790266459/LLC/整机BOM标和变压器规格书/整机BOM标2019-08-28.xls

500W双管正激套件整体BOM
名称/型号 | 位号 | 封装 | 数量 | 参考价格单价 | 备注
683/630V/1210 | C16 | 1210 | 1 | 0.75 | KEMET(基美)-C1210V683KBRAC7800 (https://list.szlcsc.com/brand/435.html)
475/50V/1206 | C5, C10, C22 | 1206 | 3 | 0.384 | 风华
106/25V/1206 | C19, C49 | 1206 | 2 | 0.285 | 风华
224/250V/1206 | C24，C45 | 1206 | 2 | 0.378 | HEC(禾伸堂)-C1206X224K251T (https://list.szlcsc.com/brand/1173.html)
223/500V/1206 | C47 | 1206 | 1 | 0.302 | YAGEO(国巨)-CC1206KKX7RBBB223 (https://list.szlcsc.com/brand/396.html)
102/1KV/1206 | C15, C17, C23, C25, C42 | 1206 | 5 | 0.116 | 风华
222/1KV/1206 | C12 | 1206 | 1 | 0.124 | 风华
103/1KV/1206 | C54 | 1206 | 1 | 0.1 | 风华
471/1KV/1206/COG | C4, C7 | 1206 | 2 | 0.274 | YAGEO(国巨)-CC1206JKNPOCBN471 (https://list.szlcsc.com/brand/396.html)
331/50V/0603 | C37 | 0603 | 1 | 0.0177 | 风华
102/50V/0603 | C40, C41 | 0603 | 2 | 0.0155 | 风华
472/50V/0603 | C34 | 0603 | 1 | 0.0186 | 风华
103/50V/0603 | C38, C43 | 0603 | 2 | 0.034 | 风华
104/50V/0603 | C14, C32, C36, C44, C46, C55 | 0603 | 6 | 0.0133 | 风华
105/50V/0603 | C30, C39, C48, C59，C33, C35 | 0603 | 6 | 0.127 | 风华
0.005R 1%/2512 | R9, R13 | 2512封装 | 2 | 0.42 | 台湾大毅-RLP25FEER005 (https://list.szlcsc.com/brand/1238.html)
22R/2512 | R1, R10 | 2512封装 | 2 | 0.1 | 厚生
1K/2512 | R12, R14 | 2512封装 | 2 | 0.137 | 厚生
1R/1206 | R53 | 1206 | 1 | 0.023 | 厚生
1.2R/1206 | R47 | 1206 | 1 | 0.02 | 厚生
2R 1%/1206 | R42 | 1206 | 1 | 0.019 | 厚生
3R 1%/1206 | R41 | 1206 | 1 | 0.2 | 厚生
3.3R/1206 | R2, R17 | 1206 | 2 | 0.2 | 厚生
12R/1206 | R11, R49 | 1206 | 2 | 0.2 | 厚生
20R 1%/1206 | R24, R25 | 1206 | 2 | 0.017 | 厚生
22R/1206 | R32, R45 | 1206 | 2 | 0.2 | 厚生
39R/1206 | R46 | 1206 | 1 | 0.2 | 厚生
220R/1206 | R99 | 1206 | 1 | 0.2 | 厚生
910R 1%/1206 | R37 | 1206 | 1 | 0.2 | 厚生
2K 1%/1206 | R34, R48, R57, R78，R80 | 1206 | 5 | 0.2 | 厚生
3.9K 1%/1206 | R43 | 1206 | 1 | 0.2 | 厚生
4.7K/1206 | R7, R19 | 1206 | 2 | 0.2 | 厚生
8.2K 1%/1206 | R85 | 1206 | 1 | 0.2 | 厚生
9.1K 1%/1206 | R79 | 1206 | 1 | 0.2 | 厚生
10K/1206 | R23 | 1206 | 1 | 0.2 | 厚生
75K/1206 | R3, R4, R6 | 1206 | 3 | 0.2 | 厚生
100K 1%/1206 | R76 | 1206 | 1 | 0.2 | 厚生
150K 1%/1206 | R77, R81 | 1206 | 2 | 0.2 | 厚生
220K/1206 | R28, R29 | 1206 | 2 | 0.2 | 厚生
470K 1%/1206 | R27 | 1206 | 1 | 0.2 | 厚生
200R/0603 | R94 | 0603 | 1 | 0.05 | 厚生
910R 1%/0603 | R62 | 0603 | 1 | 0.05 | 厚生
1K 1%/0603 | R16, R26, R82，R105 | 0603 | 4 | 0.05 | 厚生
2K 1%/0603 | R87, R89，R73, R91, R104 | 0603 | 5 | 0.05 | 厚生
2.2K 1%/0603 | R22 | 0603 | 1 | 0.05 | 厚生
3.9K 1%/0603 | R60 | 0603 | 1 | 0.05 | 厚生
10K 1%/0603 | R21,R51, R58, R83, R86, R88, R92, R97, R98,R67, R68, R74, R93 | 0603 | 13 | 0.05 | 厚生
39K 1%/0603 | R20, R84, R95, R96, R102 | 0603 | 5 | 0.05 | 厚生
100K/0603 | R100 | 0603 | 1 | 0.05 | 厚生
120K 1%/0603 | R15 | 0603 | 1 | 0.05 | 厚生
200K/0603 | R101, R103 | 0603 | 2 | 0.05 | 厚生
470K 1%/0603 | R72, R75 | 0603 | 2 | 0.05 | 厚生
910K 1%/0603 | R70 | 0603 | 1 | 0.05 | 厚生
M7 | D5, D6 | SMA | 2 | 0.046 | MDD
SS2200 | D11, D13 | SMA | 2 | 0.155 | MDD
ES5J/SMC | D2, D3, D4, D10 | SMC | 4 | 0.317 | MDD
CJ7812 | Q4 | T0-252 | 1 | 0.77 | CJ江苏长电(授权代理)
B772 | Q2, Q3, Q7 | SOT-89 | 3 | 0.288 | CJ江苏长电(授权代理)-hfe=160~320
D882 | Q6 | SOT-89 | 1 | 0.267 | CJ江苏长电(授权代理)-hfe=160~320
7.5V | ZD3, ZD4 | SOD-123 | 2 | 0.12 | CJ江苏长电(授权代理)-MMSZ4693 (https://list.szlcsc.com/brand/64.html)
13V | ZD1, ZD2 | SOD-123 | 2 | 0.14 | CJ江苏长电(授权代理)-MMSZ5243B (https://list.szlcsc.com/brand/64.html)
E1J | D7, D8, D12, D14, D15, D17, D18, D19, D20, D23, D25, D26 | SOD-123 | 12 | 0.051 | 杨杰
1N5819HW | D16 | SOD-123 | 1 | 0.18 | CJ江苏长电(授权代理)
1N4148W-G | D21, D22, D24 | SOD-123 | 3 | 0.085 | CJ江苏长电(授权代理)
2N7002K | Q10, Q12, Q13, Q15 | SOT-23 | 4 | 0.1 | CJ江苏长电(授权代理)
BLM3401 | Q11 | SOT-23 | 1 | 0.278 | CJ江苏长电(授权代理)
CJ3404 | Q8, Q16 | SOT-23 | 2 | 0.204 | CJ江苏长电(授权代理)
ME431AXG | Q9, Q14 | SOT-23 | 2 | 0.151 | 南京微盟
EL817S1(A)(TU)-F | U10, U12 | SOP4 | 2 | 0.2 | 亿光
LM258DT | U7, U11 | SOP8 | 2 | 0.4 | ST
NCP1252A | U9 | SOP8 | 1 | 2.02 | ON
PN8370NEC-T1H | U3 | 直插-DIP8 | 1 | 1.14 | 芯鹏微
102/400V | Y1, Y2, Y3, Y4, Y5, Y6, Y7, Y8 | 直插脚距10MM | 8 | 0.087 | HEL鸿志-Y15F1D102ML (https://list.szlcsc.com/brand/1219.html)
MP2474KGD3XLC | X1, X2 | 直插脚距15 | 2 | 0.343 | SRD(圣融达)
MPP105J5190916LC | C1 | 直插脚距15 | 1 | 0.254 | SRD(圣融达)
ERJ1EM470D11OT/5*11 | C20,C50,C56, C57 | 直插5*11 | 4 | 0.112 | 艾华
RM270M035E150/6.3*15 | C2, C8, C9 | 直插6.3*15 | 3 | 1.25 | PolyCap-原厂汪泽涛13798405421
ERJ1VM221F12OT/8*12 | C18, C26 | 直插8*12 | 2 | 0.326 | 艾华
ERE1VM102W20OT/12.5/20 | C3, C11, C21 | 直插12.5*20 | 3 | 0.86 | 艾华
EGD2WM100G16OT/10*16 | C13 | 直插10*16 | 1 | 0.52 | 艾华
EKM127M2GL30RRS1P/18*30 | C6, C51, C52, C53 | 直插18*30 | 4 | 3.82 | 万裕-叶海光-13850537224
KNH8150A | Q1, Q5 | 直插-TO-247 | 2 | 4.22 | KIA
MBR40200 | D1, D9 | 直插-TO-247 | 2 | 2.82 | 海矽美-朱小姐-QQ：610546668
14D-561K | R5 | 直插 | 1 | 0.407 | HEL鸿志-14D561K (https://list.szlcsc.com/brand/1219.html)
GBJ5010 | BD1 | 直插 | 1 | 2.86 | MDD
12A 250V/5*20陶瓷/包热缩套管 | F1 | 直插 | 1 | 1.14 | Littelfuse(美国力特)-0324012.MXP (https://list.szlcsc.com/brand/110.html)
300V 1A | F2 | 直插 | 1 | 0.194 | TLC(竞沃)-SQT1.00M (https://list.szlcsc.com/brand/11675.html)
SMIH-S-112LM | K1 | 直插 | 1 | 2.7 | 淘宝-恒金电源（店铺）
SQ1918030153808L | LF1 | 直插 | 1 | 1.6 | 扁平共模电感-辛旭生-13701530232
8.25*3P | P1 | 直插 | 1 | 0.582 | DIBO(地博电子)-DBT50-8.25-3P (https://list.szlcsc.com/brand/11964.html)
12V 0.2A/4020风扇 | P2 | 直插-风机端口-2.54*2 | 1 | 15 | SNOWFAN -YY4020H12S 4020
NTC10K 3435/2.54端子/20CM | P3 | 直插-NTC端口-2.54*2 | 1 | 1.2 | 淘宝-深圳市东鑫创电子
散热片-F2-5孔 | J6 | 直插-绝缘片 | 1 | 3.2 | 淘宝-悦享生活家
散热片-F2-4孔 | J7 | 直插-绝缘片 | 1 | 2.5 | 淘宝-悦享生活家
4020风机安装位置 | J8 | 直插 | 1 | 0
5D-9 | R18 | 直插 | 1 | 0.141 | HEL鸿志-5D-9 (https://list.szlcsc.com/brand/1219.html)
100R 10W/长脚定做 | R8 | 直插 | 1 | 0.45 | 淘宝-优翔电子
M4螺母端子+方螺丝+接线鼻 | V+1, V-1 | 直插-M4端子 | 2 | 0.83 | 淘宝-鑫硕电子五金厂
固定铜柱M3*6MM | J1, J2, J3, J4, J5, J9 | 直插-M3 | 6 | 0.05 | 淘宝-以瑟旗舰店
输出调电压接口2.54*4P | P4 | 直插-2.54 4PIN立式 | 1 | 0.06
90度单排弯针2.54*8 | P5, P10, P11, P12, P13, P14 | 直插-2.54*8 | 6 | 0.015 | BOOMELE(博穆精密) (https://list.szlcsc.com/brand/86.html)
90度单排弯针2.54*5 | P6, P7, P8, P9 | 直插-2.54*5 | 4 | 0.015 | 型号：排针2.54-单排13P反弯
15uh/PQ2625 | L2 | 直插-PQ26 | 1 | 6.5 | 变压器厂，邓工：13530050515
22uh输出续流电感 | L1 | 直插 | 1 | 7.5 | 变压器厂，邓工：13530050515
EE10 1：100电流互感器 | CT2 | 直插-EE10 | 1 | 1 | 变压器厂，邓工：13530050515
EE13驱动变压器 | T3 | 直插-EE13/5+5 | 1 | 1.5 | 变压器厂，邓工：13530050515
EE16辅助电源变压器 | T2 | 直插-EE16 | 1 | 1.8 | 变压器厂，邓工：13530050515
ER4220主功率变压器 | T1 | 直插-ER4220 | 1 | 25 | 变压器厂，邓工：13530050515
其他辅料
六角铜柱M3单头铜螺柱M3*15 | J1, J3, J4, J5, J9 |  | 5 | 1.2 | 淘宝-以瑟旗舰店
固定散热片M3平头螺丝M3*6MM |  |  | 4 | 0.05 | 淘宝-以瑟旗舰店
MOS二极管锁散热片组合螺丝M3*12 |  |  | 6 | 0.11 | 淘宝-以瑟旗舰店
MOS和二极管绝缘片 |  |  | 4 | 0.22 | 兴勤导热-陈梦凝-18025851642
导热硅脂45g装-针管 |  |  | 1 | 5 | 兴勤导热-陈梦凝-18025851642
风扇和NTC位置2.54接插件*2套 |  |  | 1 | 0.12
风扇固定扎带3*200 |  |  | 2 | 0.026 | 淘宝-以瑟旗舰店
