790266459/LLC/主控制板原文件/控制主板.xls

Comment | Description | Designator | Footprint | LibRef | Quantity
104/50V/0603 | Capacitor | C14, C36, C44, C46 | 0603 | CAP | 4
475/50V/1206 | Capacitor | C22 | 1206 | CAP | 1
105/50V/0603 | Capacitor | C33, C35 | 0603 | CAP | 2
472/50V/0603 | Capacitor | C34 | 0603 | CAP | 1
331/50V/0603 | Capacitor | C37 | 0603 | CAP | 1
103/50V/0603 | Capacitor | C38, C43 | 0603 | CAP | 2
105/25V/0603 | Capacitor | C39, C48 | 0603 | CAP | 2
102/50V/0603 | Capacitor | C40, C41 | 0603 | CAP | 2
102/1KV/1206 | Capacitor | C42 | 1206 | CAP | 1
224 250V/1206 | Capacitor | C45 | 1206 | CAP | 1
223/500V/1206 | Capacitor | C47 | 1206 | CAP | 1
1N4148W-G | Diode | D21, D22 | SOD-123 | DIODE | 2
E1J | Diode | D23, D26 | SOD-123 | DIODE | 2
2.54*8 | Header, 8-Pin | P11, P13 | 2.54*8 | Header 8 | 2
D882 | NPN General Purpose Amplifier | Q6 | D882 | 2N3904 | 1
D772 | PNP General Purpose Amplifier | Q7 | D772 | 2N3906 | 1
2N7002K |  | Q10, Q12 | SOT-23/MOS | MOSFET N | 2
ME431AXG | Silicon Controlled Rectifier | Q14 | ME431AXG | SCR | 1
120K 1%/0603 |  | R15 | 0603 | RES2 | 1
1K 1%/0603 |  | R16, R26, R82 | 0603 | RES2 | 3
39K 1%/0603 |  | R20, R84 | 0603 | RES2 | 2
10K 1%/0603 |  | R21, R93 | 0603 | RES2 | 2
2.2K 1%/0603 |  | R22 | 0603 | RES2 | 1
20R 1%/1206 |  | R24, R25 | 1206 | RES2 | 2
470K 1%/1206 |  | R27 | 1206 | RES2 | 1
39R/1206 |  | R46 | 1206 | RES2 | 1
10K/0603 |  | R51, R83, R86, R88 | 0603 | RES2 | 4
2K/0603 |  | R73, R91, R104 | 0603 | RES2 | 3
470K 1%/0603 |  | R75 | 0603 | RES2 | 1
100K 1%/1206 |  | R76 | 1206 | RES2 | 1
150K 1%/1206 |  | R77, R81 | 1206 | RES2 | 2
2K/1206 |  | R78 | 1206 | RES2 | 1
9.1K 1%/1206 |  | R79 | 1206 | RES2 | 1
2K 1%/1206 |  | R80 | 1206 | RES2 | 1
8.2K 1%/1206 |  | R85 | 1206 | RES2 | 1
2K 1%/0603 |  | R87, R89 | 0603 | RES2 | 2
220R/1206 |  | R99 | 1206 | RES2 | 1
100K/0603 |  | R100 | 0603 | RES2 | 1
NCP1252A |  | U9 | SOP8 | Component_1 | 1
EL817S1(A)(TU)-F | 4-Pin Phototransistor Optocoupler | U10, U12 | EL817A | Optoisolator1 | 2
LM258 |  | U11 | SOp8 | AP4310 | 1
13V | Diode Tunnel | ZD1, ZD2 | SOD-123 | DIODE TUNNEL | 2
