790266459/LLC/整机原理图/总原理图2019-10-05.pdf

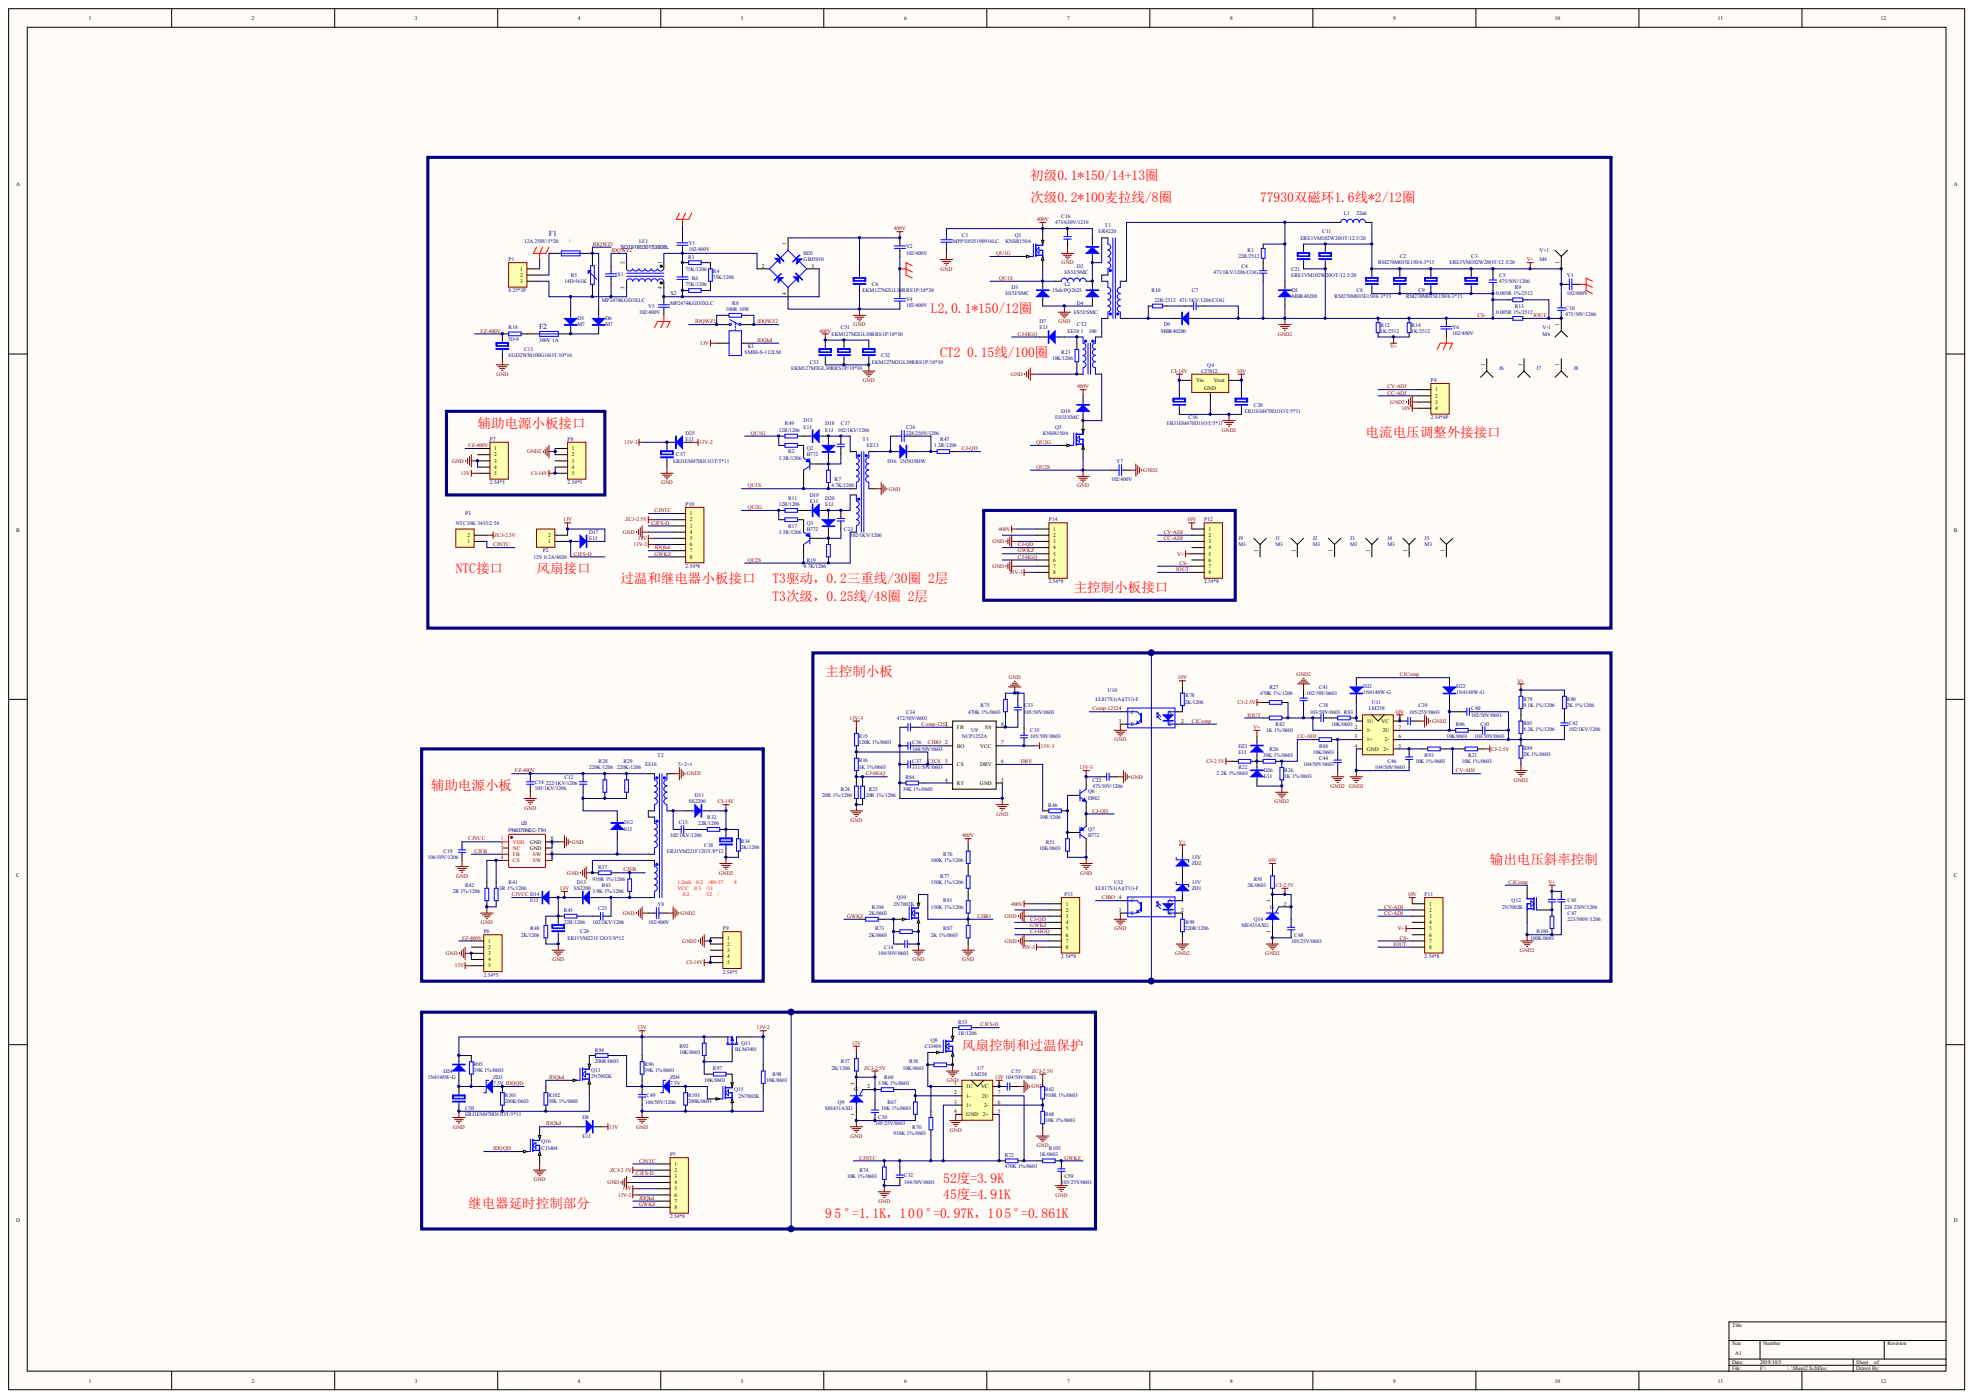
[picture p1: page 1]
