790266459/LLC/顶部和底部贴片图/底部贴片图.pdf

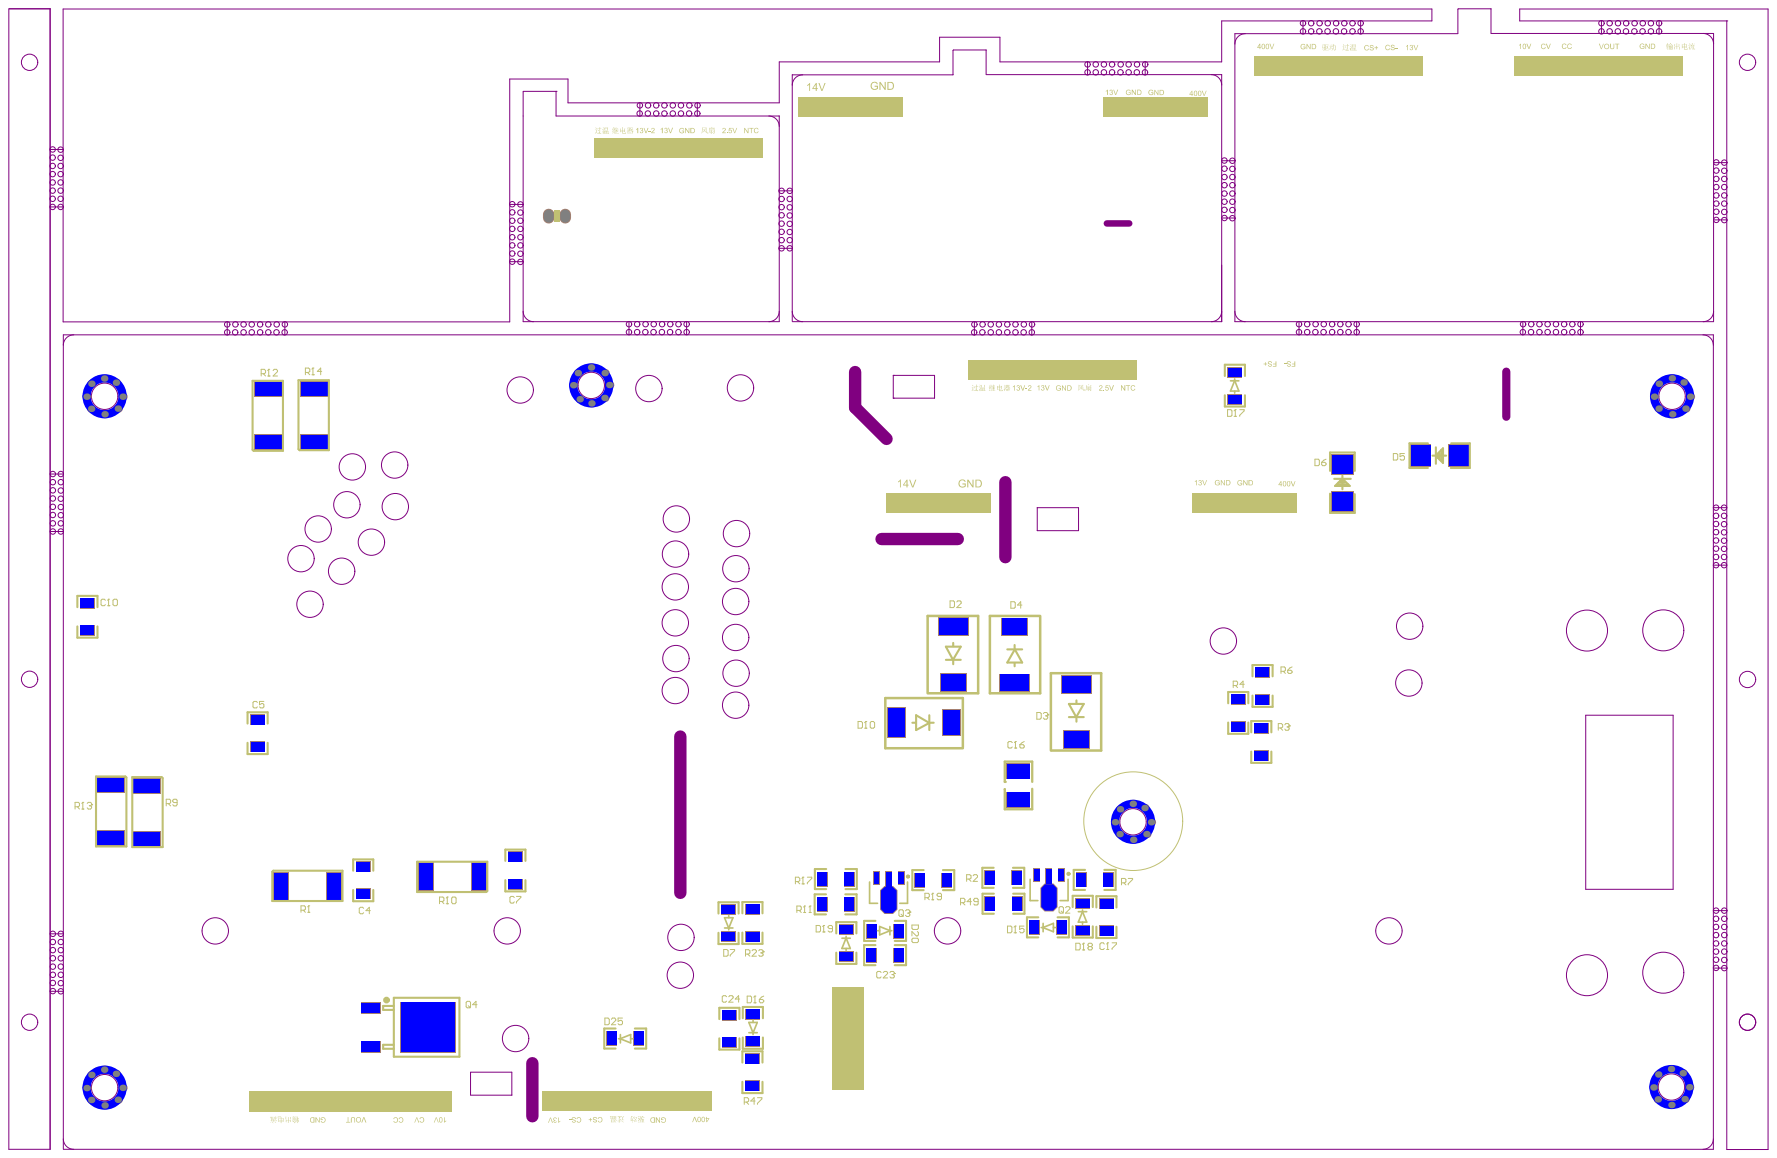
[picture p2: page 1]
