790266459/LLC/顶部和底部贴片图/顶部贴片图.pdf

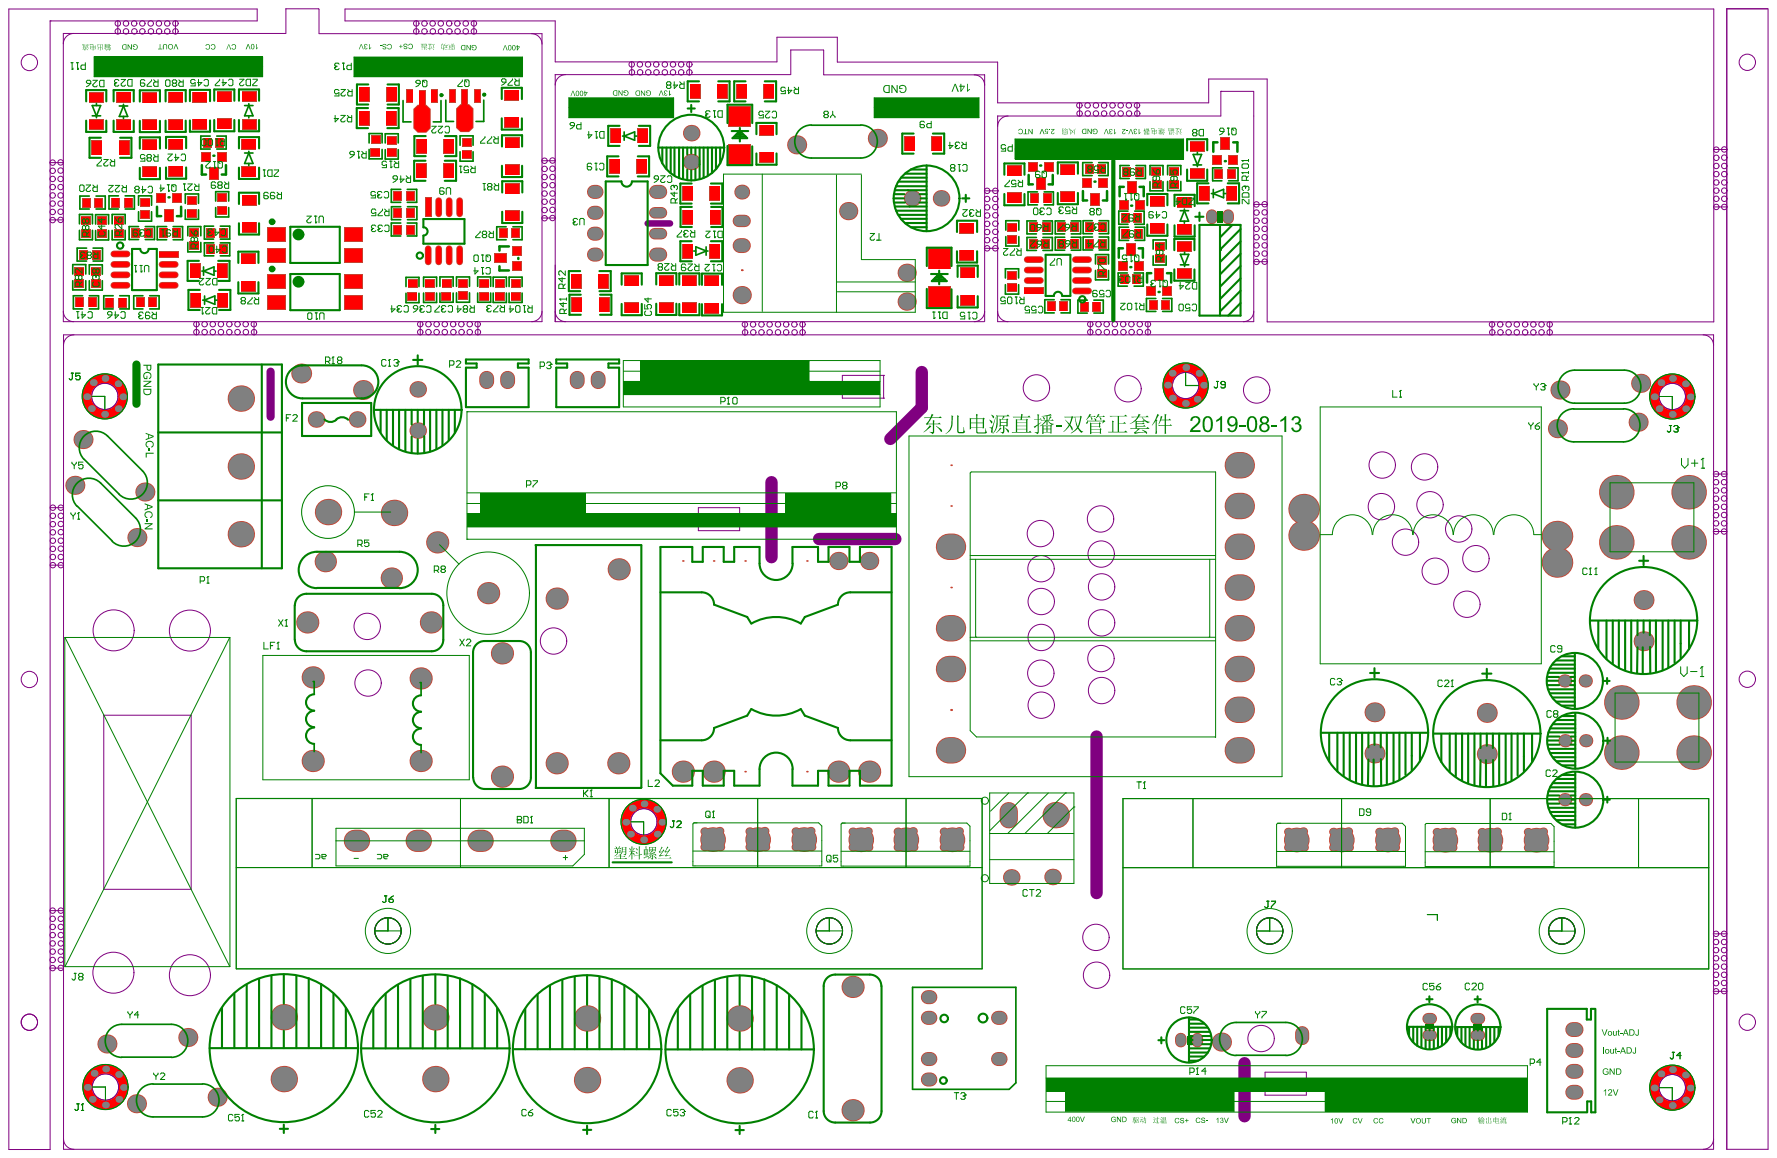
[picture p3: page 1]
