790266459/LLC/仿真软件和仿真文件/主回路仿真.asc

C1: cap; 470p
C3: cap; 10µ
C4: cap; 220p
C5: cap; 100p
C6: cap; 0.2n
C7: cap; 100p
D1: diode; RFN20T2D
D2: diode; RFN20T2D
D3: diode; RFN5TF8S
D4: diode; RFN5TF8S
D5: diode; RFN5TF8S
D6: diode; RFN5TF8S
L1: ind; 10µ
L2: ind; 1µ
L3: ind2; 1000µ
L4: ind; 100µ
L5: ind2; 80µ
M1: nmos; STW11NM80
M2: nmos; STW11NM80
R1: res; 10R
R2: res; 10R
R3: res; 1.1R
R4: res; 30R
R5: res; 30R
R6: res; 10r
R8: res; 10r
V1: voltage; PULSE(0 12 1n 100n 100n 4.5u 10u)
V2: voltage; PULSE(0 12 1n 100n 100n 4.5u 10u)
V3: voltage; 200v
Named nets: 0
K1 L3 L5  1
.tran 0 1ms 0 50u
