790266459/LLC/仿真软件和仿真文件/驱动变压器+主回路仿真，下管VDS有个沟是变压器电容或者次级吸收电容大了.asc

C1: cap; 100µ
C2: cap; 470p
C3: cap; 470p
C4: cap; 10pF
C5: cap; 220n
C6: cap; 1n
C7: cap; 5µ; V=500V
C9: cap; 4.7µ; V=50V
C10: cap; 1n
D1: diode; MUR460
D2: diode; MUR460
D3: diode; MURS320
D4: diode; MURS320
D5: diode; MUR460
D6: diode; MUR460
D7: diode; 1N4148
D8: diode; 1N4148
D9: diode; MUR460
D11: diode; MUR460
D12: diode; 1N4148
L1: ind; 1µ
L2: ind2; 1500µ
L3: ind2; 131.7µ
L4: ind; 25µ
L5: ind; 15µ
L6: ind2; 600µ
L7: ind2; 1536µ
L8: ind2; 1536µ
M1: nmos; STP8NM60
M2: nmos; STP8NM60
Q1: npn; 2N4124
Q4: pnp; 2N4126
Q5: pnp; 2N2907
Q7: pnp; 2N2907
R1: res; 0.001r
R2: res; 0.001R
R3: res; 1.14r
R4: res; 22r
R5: res; 22r
R6: res; 0.001
R7: res; 39R
R8: res; 12R
R9: res; 4.7K
R10: res; 3.3R
R11: res; 1.2R
R12: res; 12R
R13: res; 4.7K
R14: res; 3.3R
R15: res; 10K
R16: res; 10K
R17: res; 10K
V1: voltage; 100V
V4: voltage; 15V
V5: voltage; PULSE(0 30 1n 50n 50n 4.5u 10u)
Named nets: 0
K1 L2 L3 1
.tran 0 5ms 1us 1us
K2 L6 L7 L8 1
