790266459/LLC/仿真软件和仿真文件/驱动变压器正压驱动仿真.asc

C1: cap; 220nf
C2: cap; 1nf
C3: cap; 2.2n
D2: diode; 1N4148
D3: diode; MUR460
D4: diode; 1N4148
L1: ind2; 1000µh
L2: ind2; 2560µh
M1: nmos; AO6408
Q1: npn; 2N3019
Q2: pnp; BCW68F
Q3: pnp; 2N2907
R1: res; 100r
R2: res; 10r
R3: res; 10k
R4: res; 4.7k
V1: voltage; PULSE(0 15 1n 50n 50n 4.5us 10us)
V2: voltage; 15v
V3: voltage; PULSE(0 15 1n 50n 50n 100us 500us)
Named nets: 0
K1 L1 L2 1
.tran 0 5ms 1n 1u startup
