790266459/LLC/(list of files, drawings)

Other design files:
主控制板原文件/PCB4.PcbDoc
主控制板原文件/PCB_Project4.PrjPCB
主控制板原文件/Sheet4.SchDoc
